mathew-hall/GBCartRead-PIC16/Schematic (Schematic).pdf

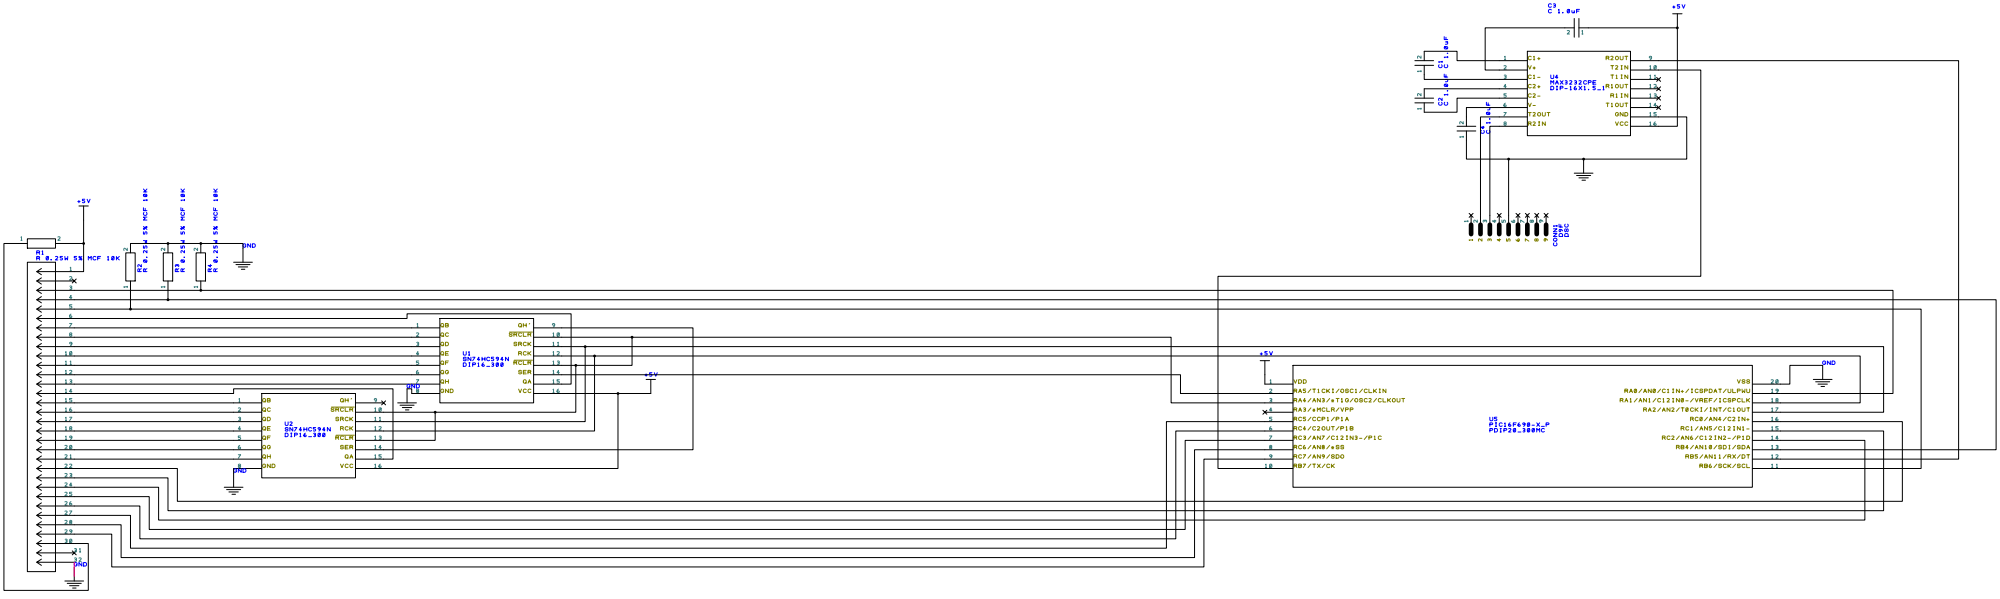
[picture p1: page 1]
